Xinyuan-LilyGO/T7-C5/3D_Files/T7-C5 V1.0.step

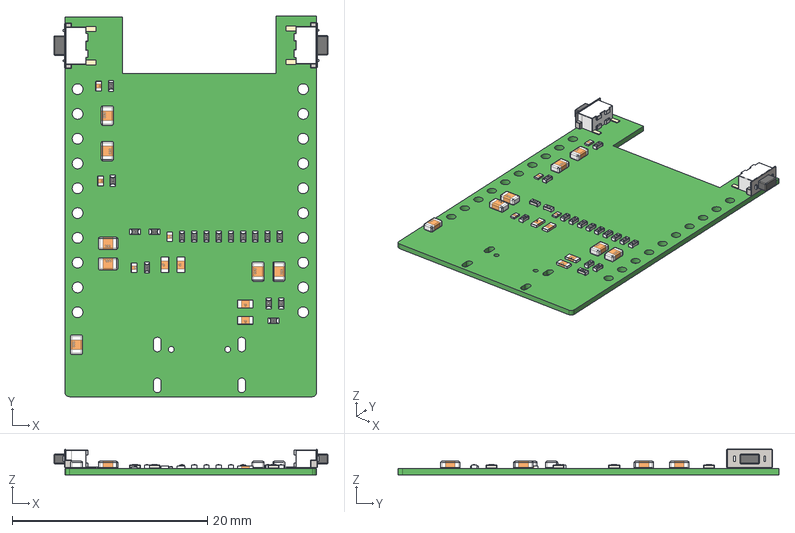
[picture p1: CAD file, 2026-09-09]
3D_Files/T7-C5 V1.0.step
28.1 x 39.0 x 2.62 mm
User_Library-0805_SMD_Capacitor x 7
User_Library-0603_SMD_Capacitor x 4
User_Library-RES_1005-0402 x 17
0402_SMD_Capacitor x 4
User_Library-2X4X3_5mm_switch x 2
