Xinyuan-LilyGO/T7-C5/Hardware/T7-C5.pdf

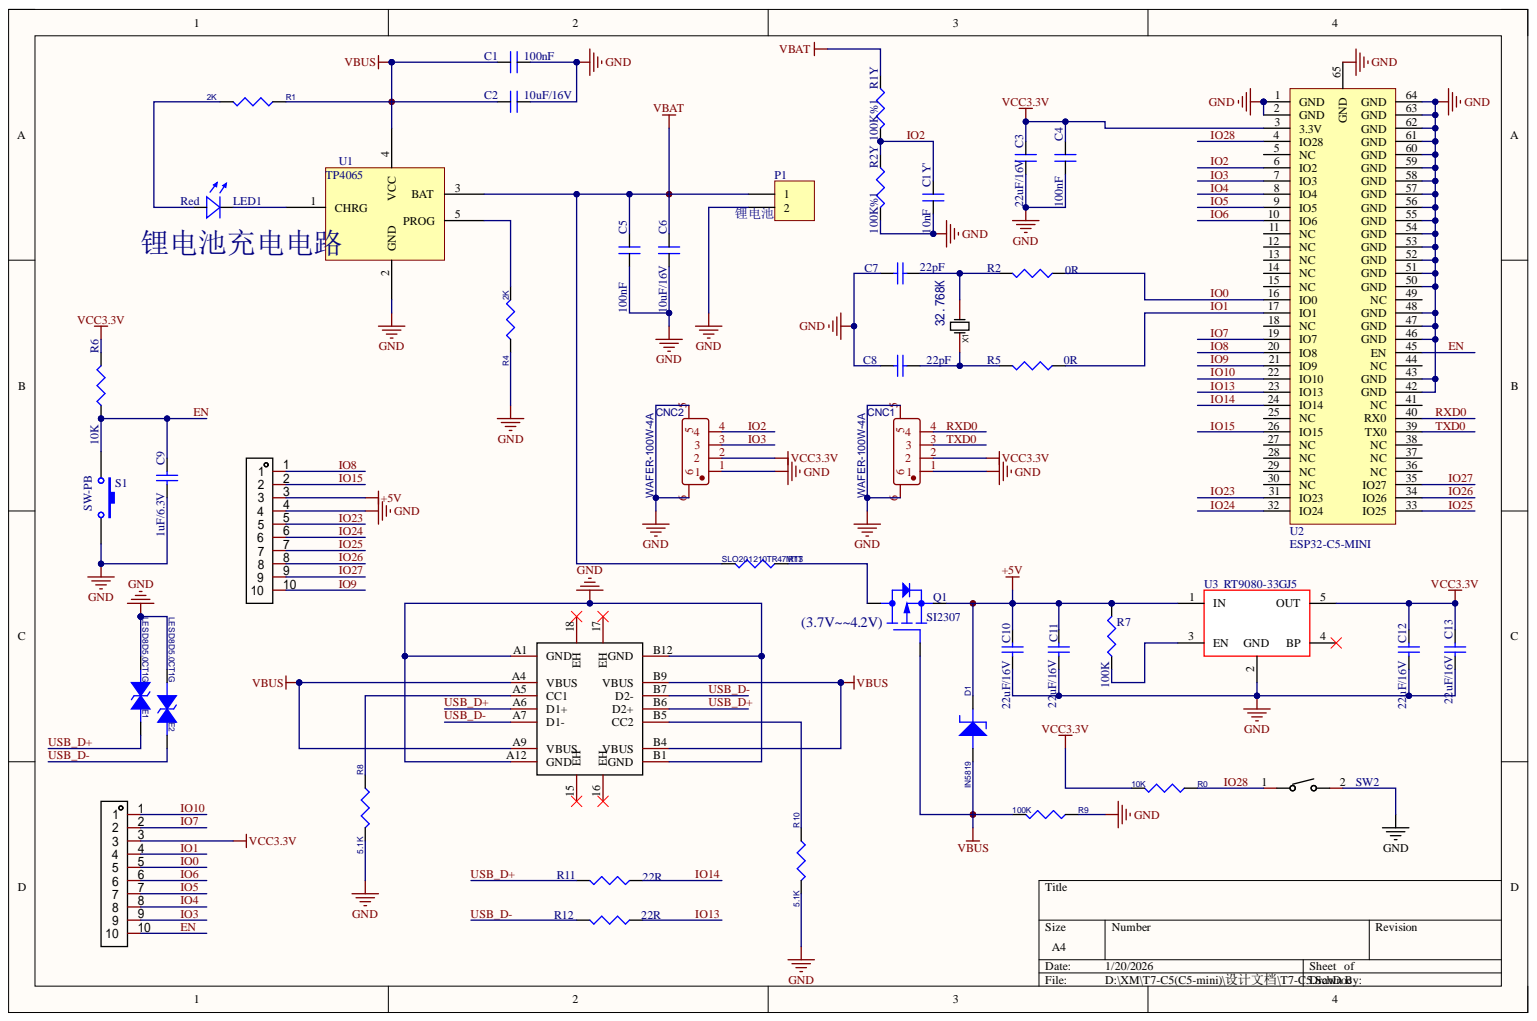
[picture p2: page 1]
